icl-rocketry/Ricardo-Chad/(commit log)

2024-02-12 Thanos-R hotfire 11/02/2024 fixes
    [system.cpp]
2024-02-14 fixed pins being setup as inputs and random command switching
2024-02-19 Forgot to call odrive state machine ...
2024-02-20 chamberP based throttling
2024-02-20 added csv with controller params
    [NRCThanos_params.csv]
2024-02-23 changed calls to motor functions to oDriveState changes
2024-02-23 ox fill open during test
    [NRCThanos_params.csv]
2024-02-24 cold flow setup
    [NRCThanos_params.csv]
2024-07-08 removed thanos controller
    [ricpart.csv]
2024-07-08 Pulled in voltage reading fix from other branches
    [system.h, vrailmonitor.cpp, vrailmonitor.h]
2024-07-11 Maybe chad v3.0 hardware
    [Chad.kicad_pcb, Chad.kicad_sch, buckC.kicad_sch, can.kicad_sch, power.kicad_sch, usb-uart.kicad_sch]
2024-07-11 RAE logo
    [Chad.kicad_pcb, Chad.kicad_sch, power.kicad_sch, usb-uart.kicad_sch]
2024-07-12 Buck converter error flag
    [system.cpp]
2024-08-15 30V compatibility update
    [Chad.kicad_pcb, Chad.kicad_sch, bom.csv, buckC.kicad_sch, can.kicad_sch, designators.csv, positions.csv, power.kicad_sch]
2024-08-17 Resistor values
    [Chad.kicad_pcb, Chad.kicad_sch, buckC.kicad_sch]
2024-08-18 Added GPIO TVS protection
    [Chad.kicad_pcb, Chad.kicad_sch, GPIO.kicad_sch, bom.csv, buckC.kicad_sch, designators.csv, positions.csv, servo.kicad_sch]
2024-08-22 Fixed buck class spams serial bug
2024-09-04 updated to new servo class
2024-09-05 split buck error into 2 different flags
2024-09-05 fixed pgood hardware issue
    [Chad.kicad_pcb, Chad.kicad_sch, bom.csv, buckC.kicad_sch, designators.csv, positions.csv]
2024-09-07 Fixed both servos running on same local PWM
    [system.cpp]
2024-09-10 v3 ordered
    [Chad.kicad_pcb]
2024-09-28 switched to 240MHz
2025-01-09 .ini changes and submodule updates, removed vrailmonitor momentarily as old ADC api doesn't compile
    [system.cpp, system.h, vrailmonitor.cpp, vrailmonitor.h]
2025-02-01 Copied Kiran's vrail monitor for servo voltage, this should eventually be a HAL...
2025-03-07 Updated menuconfig to new template conf + submodules to v4-DEV
    [ricpart.csv]
2026-05-16 Low-pass filter working
